AleksaHeler/Guitar-Amp/pics/original/marshall-mg10-pcb-2.jpg

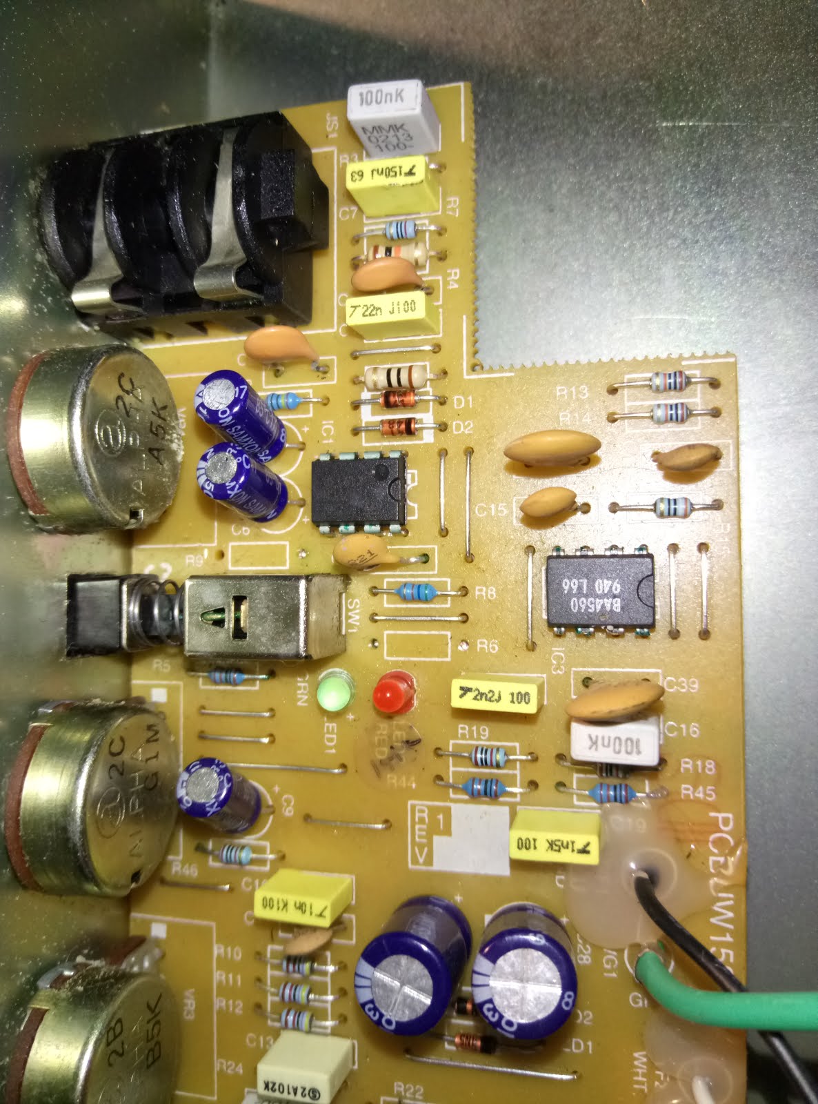
pics/original/marshall-mg10-pcb-2.jpg
