AleksaHeler/Guitar-Amp/pics/original/marshall-mg10-pcb-3.jpg

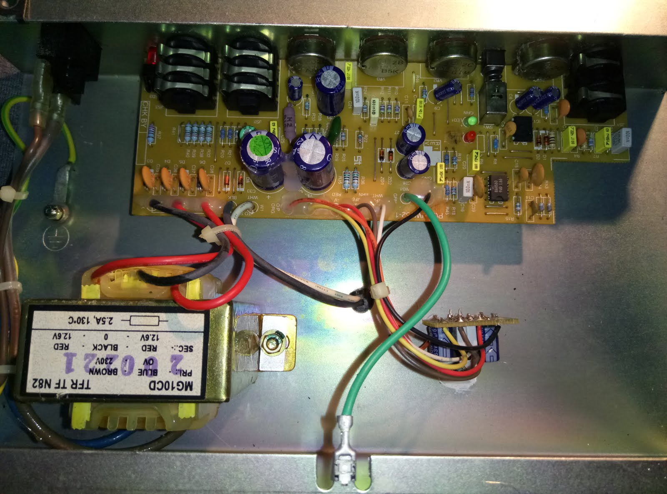
pics/original/marshall-mg10-pcb-3.jpg
