AleksaHeler/Guitar-Amp/README.md

# Guitar-Amp

Making a solid state combo guitar amp from scratch, based on Marshall MG10 with some custom modifications.

I'm designing my own schematic and PCB, and making the wooden speaker cabinet.

## Resources

...

## Schematic

...

## PCB

...
