AleksaHeler/Guitar-Amp/docs/pcb.png

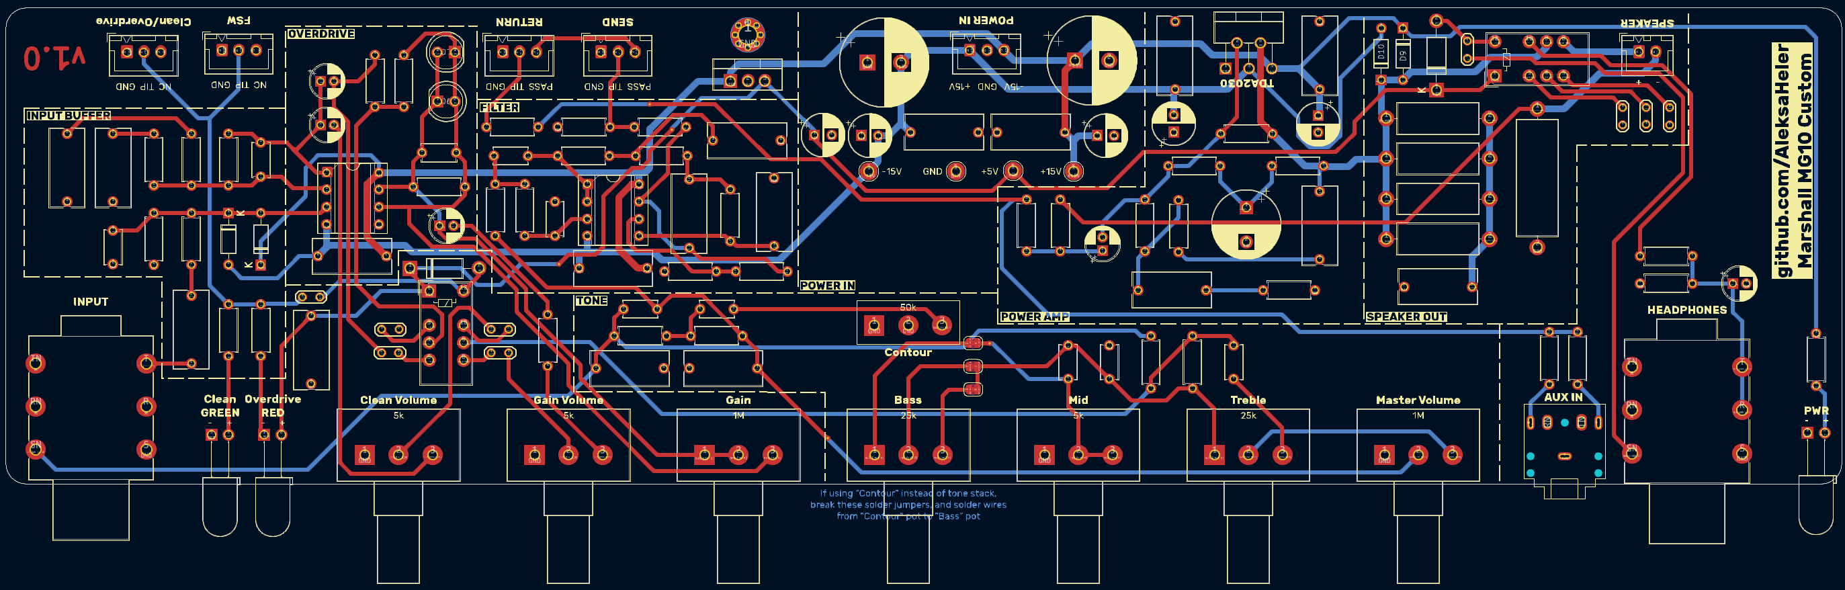
docs/pcb.png
