AleksaHeler/Guitar-Amp/docs/pcb_3d_view.png

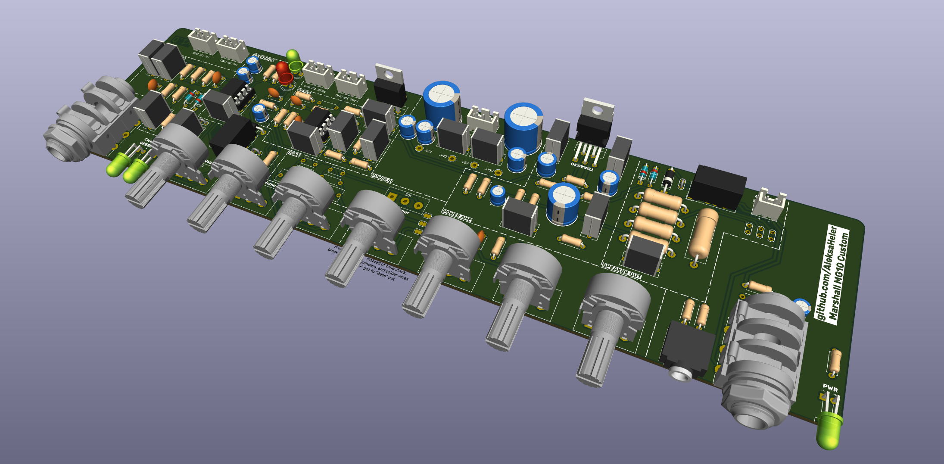
docs/pcb_3d_view.png
