AleksaHeler/Guitar-Amp/docs/pcb_top_view.png

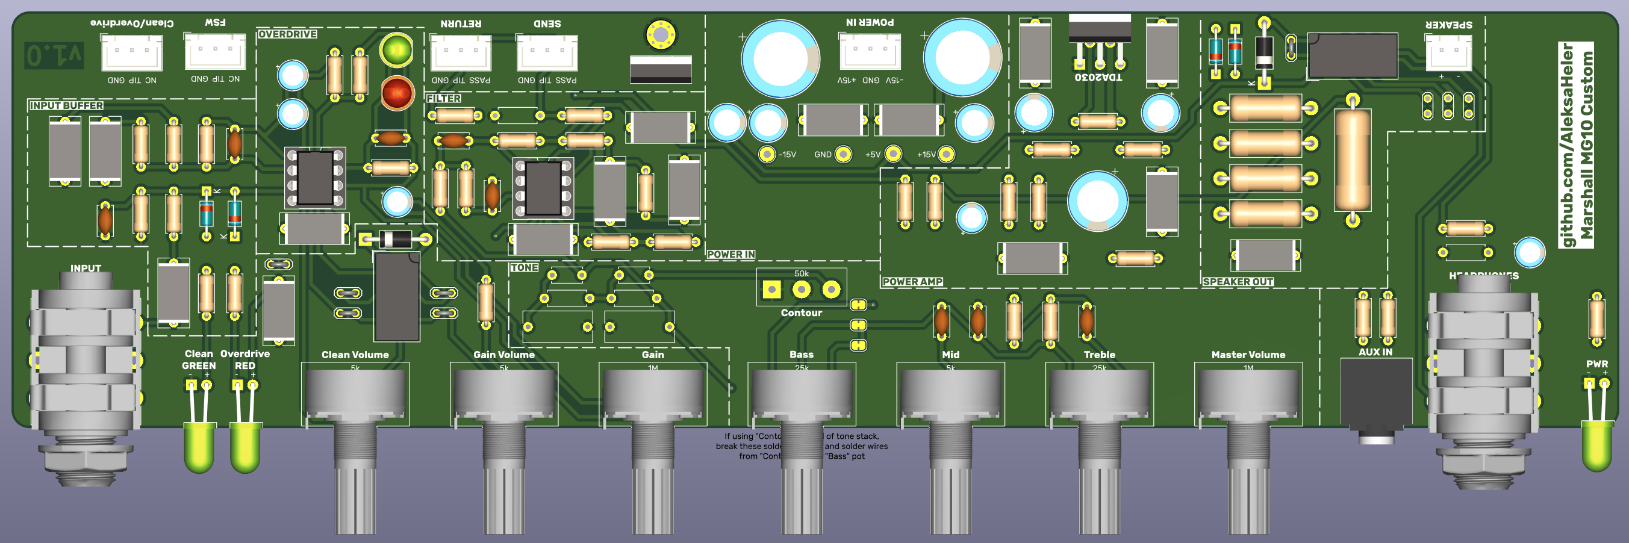
docs/pcb_top_view.png
