AleksaHeler/Guitar-Amp/pics/original/marshall_amp.webp

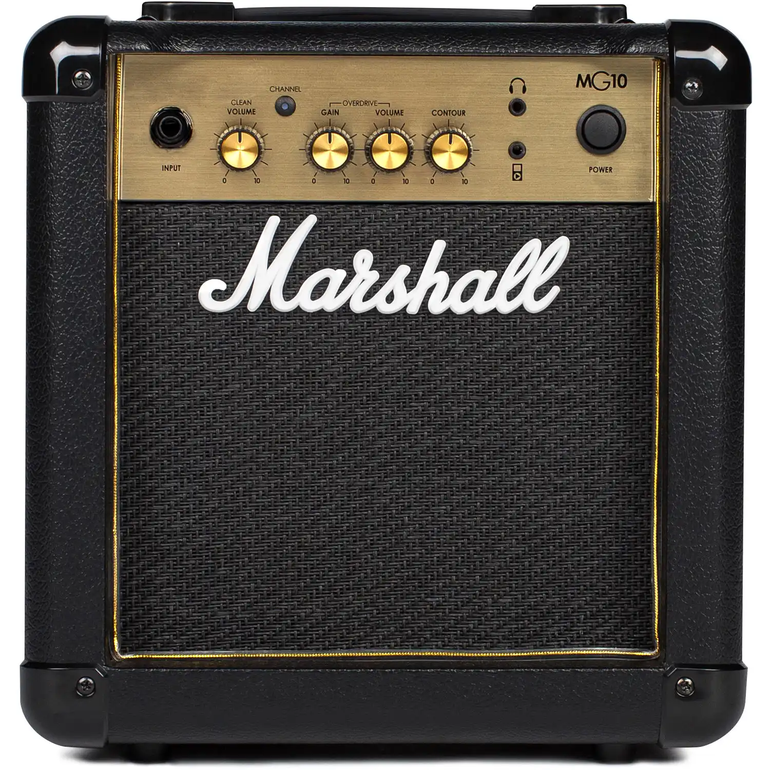
pics/original/marshall_amp.webp
