AleksaHeler/Guitar-Amp/my_mg10/models/6.35mm Mono Jack Socket Connector.STEP

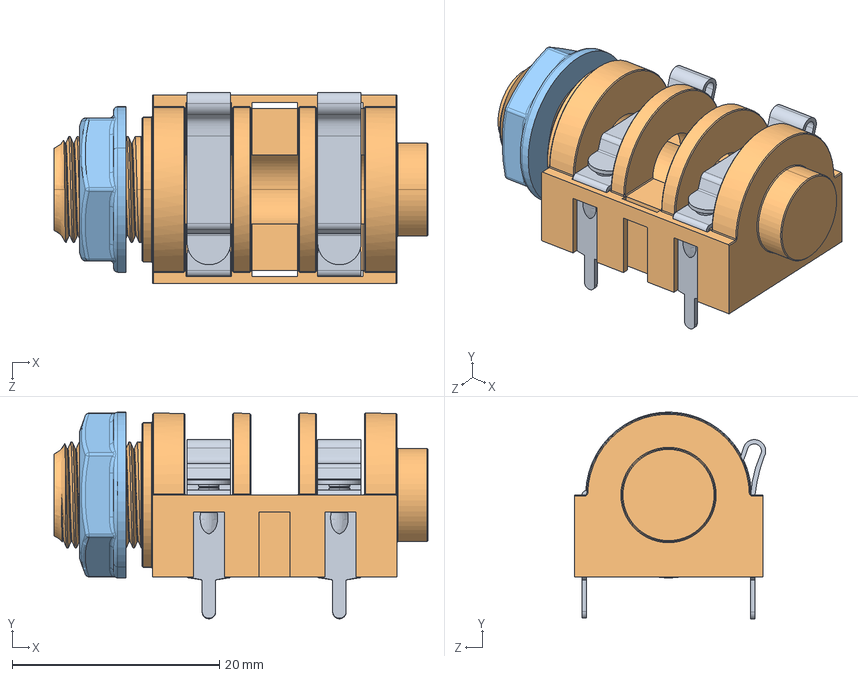
[picture p7: CAD file, 2025-08-31]
my_mg10/models/6.35mm Mono Jack Socket Connector.STEP
36.1 x 19.9 x 18.5 mm
6_3 Jack body
Nut
6_3 Jack contact_01 x 2
6_3 Jack contact_02 x 2
