AleksaHeler/Guitar-Amp/my_mg10/models/potentiometer_B10K.STEP

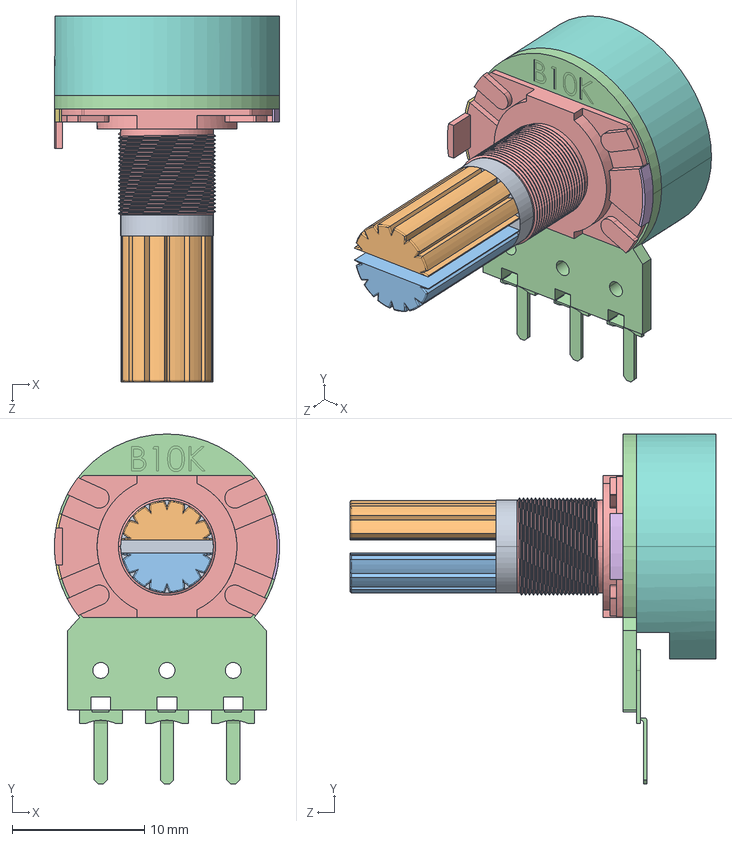
[picture p8: CAD file, 2025-08-31]
my_mg10/models/potentiometer_B10K.STEP
17.0 x 26.4 x 27.6 mm
