AleksaHeler/Guitar-Amp/docs/schematic_v1.0.pdf

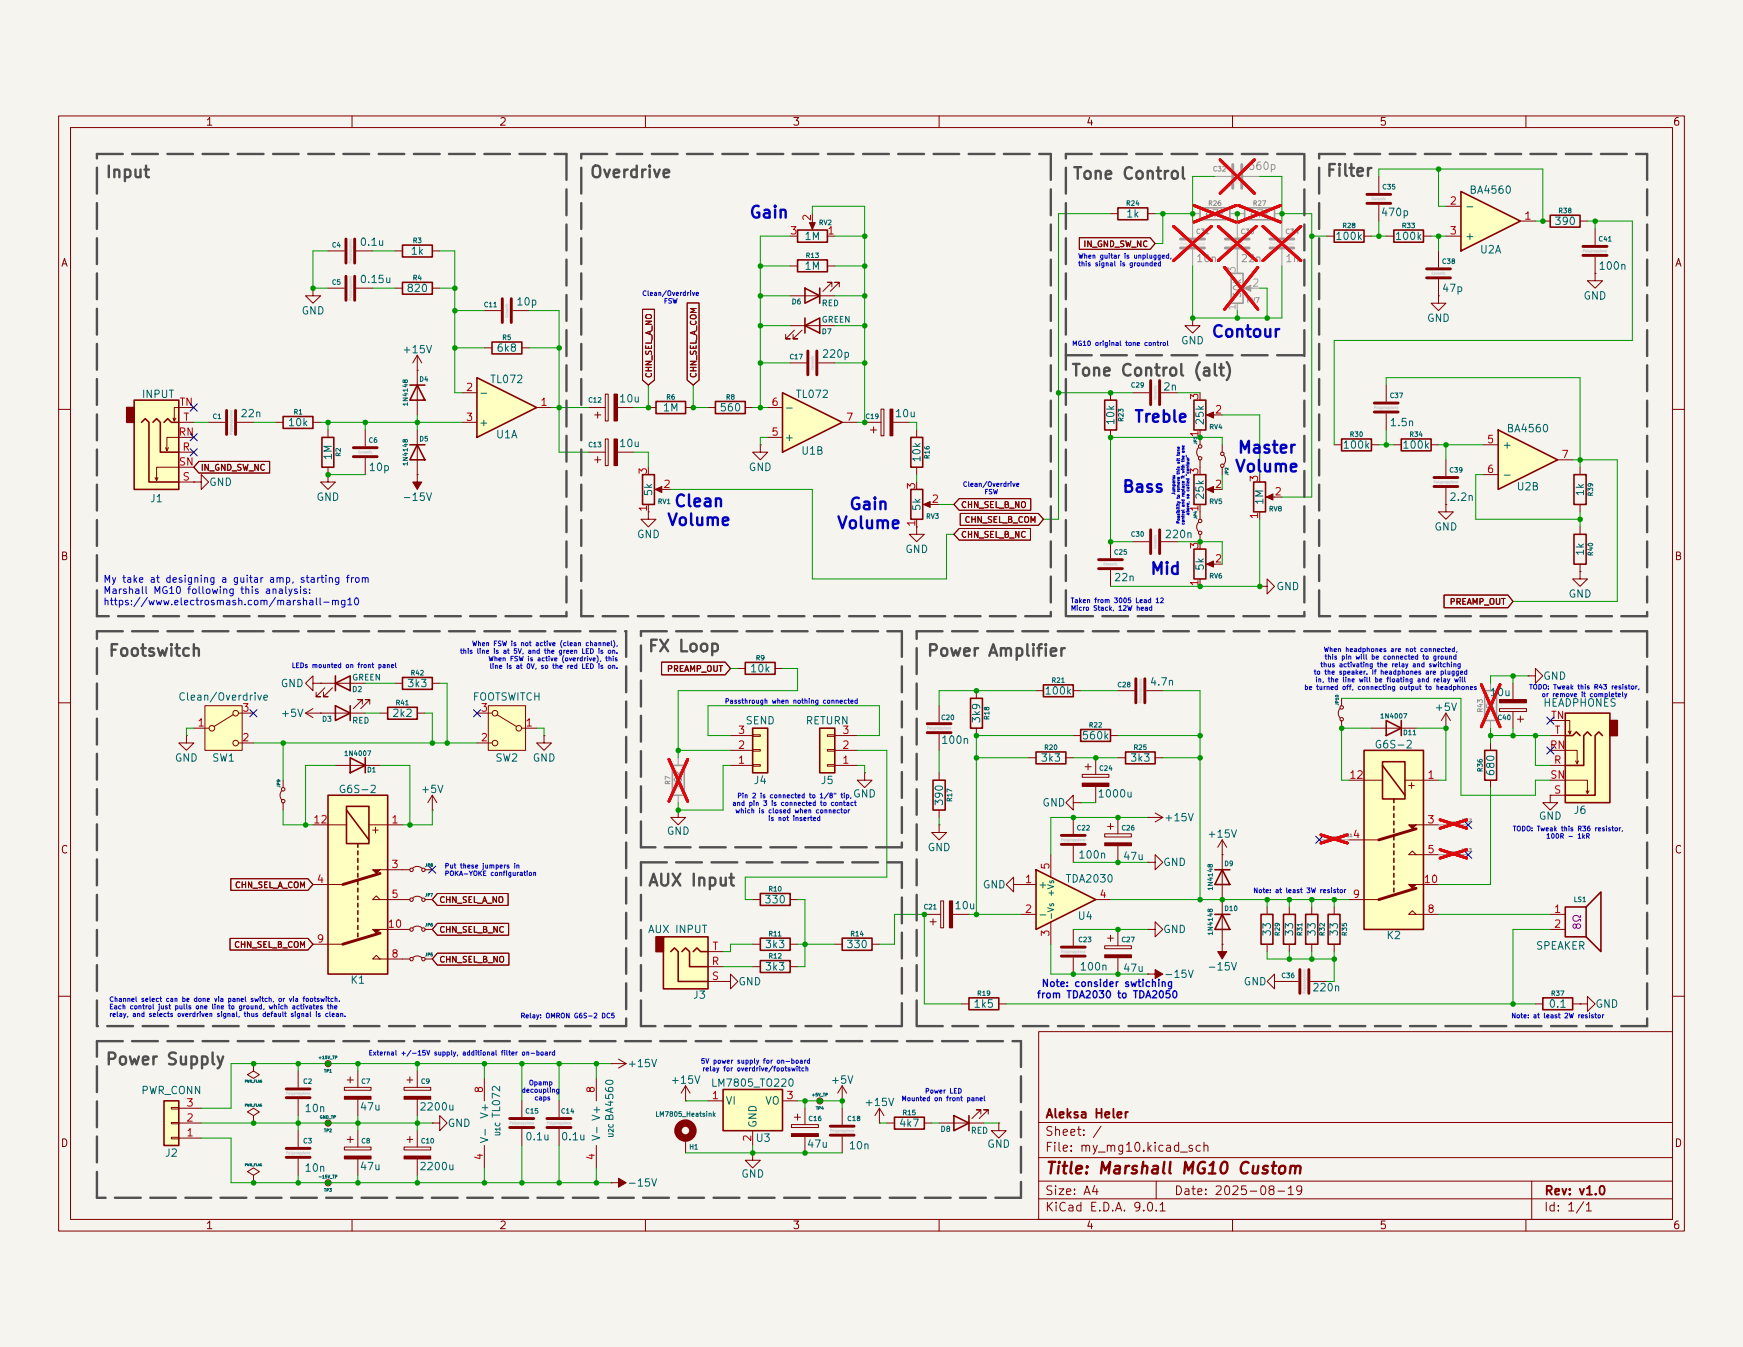
[picture p9: page 1]
