AleksaHeler/Guitar-Amp/my_mg10/my_mg10.kicad_pcb

## KiCad design my_mg10/my_mg10.kicad_pcb (2025-09-01)

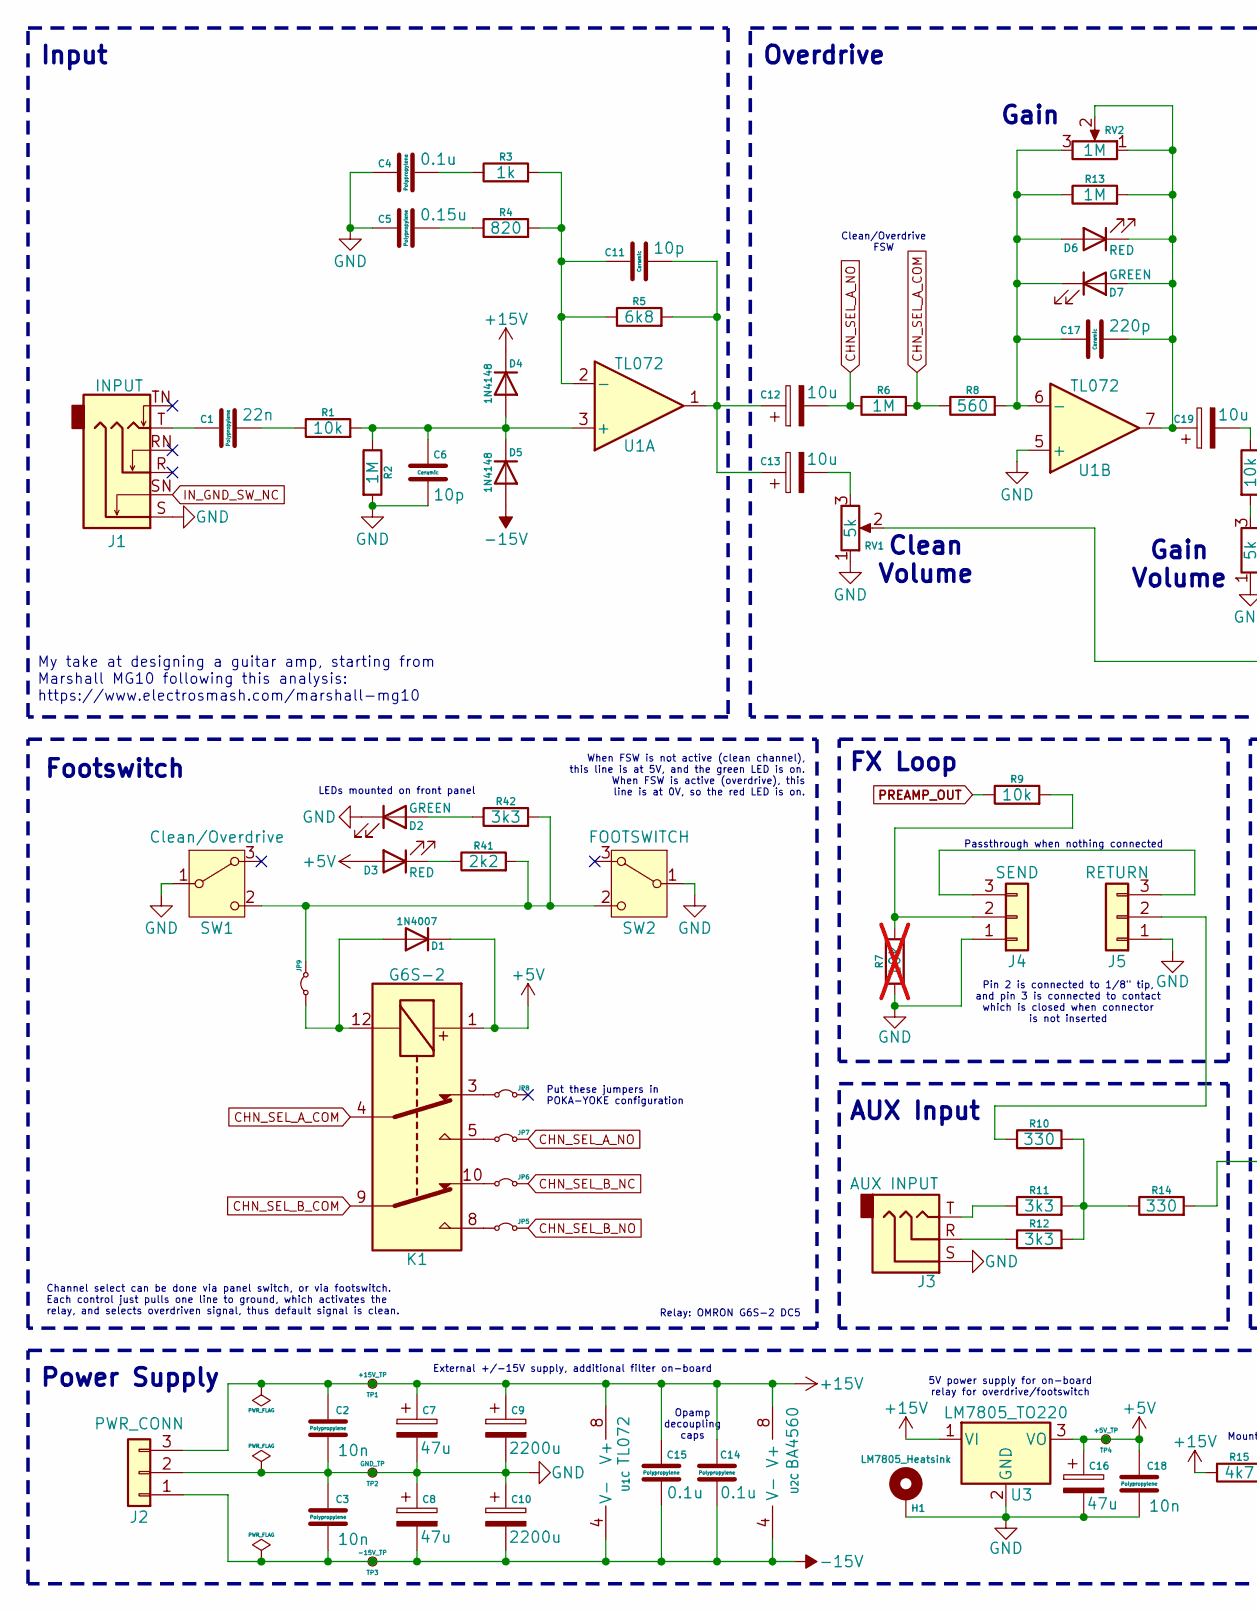
[picture p10: schematic my_mg10.kicad_sch, Marshall MG10 Custom, part in row 1, column 1]

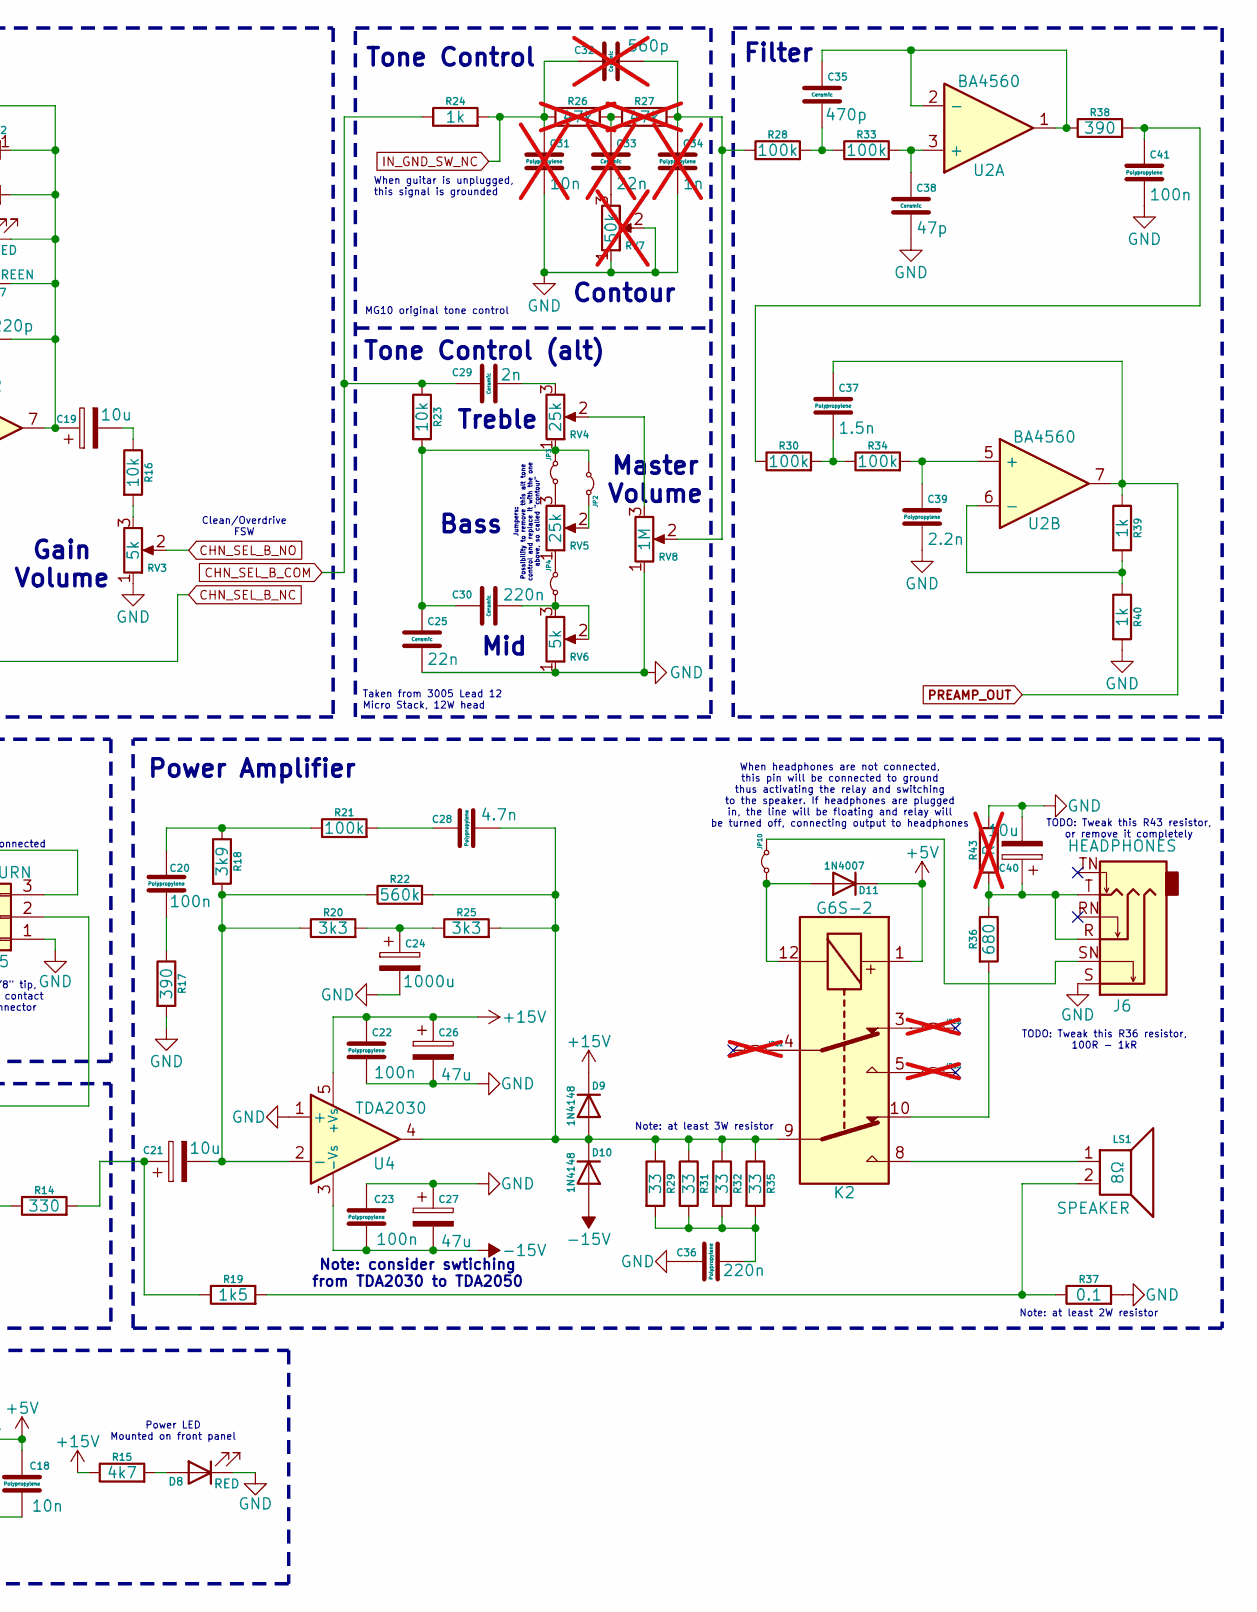
[picture p11: schematic my_mg10.kicad_sch, Marshall MG10 Custom, part in row 1, column 2]

Parts:
C1: 22n; C_Rect_L11.5mm_W5.1mm_P10.00mm_MKT
C2, C3, C18: 10n; C_Rect_L11.5mm_W5.1mm_P10.00mm_MKT
C4, C14, C15: 0.1u; C_Rect_L11.5mm_W5.1mm_P10.00mm_MKT
C5: 0.15u; C_Rect_L11.5mm_W5.1mm_P10.00mm_MKT
C6, C11: 10p; C_Disc_D5.0mm_W2.5mm_P5.00mm
C7, C8, C16, C26, C27: 47u; CP_Radial_D6.3mm_P2.50mm
C9, C10: 2200u; CP_Radial_D13.0mm_P5.00mm
C12, C13, C19, C21, C40: 10u; CP_Radial_D5.0mm_P2.00mm
C17: 220p; C_Disc_D5.0mm_W2.5mm_P5.00mm
C20, C22, C23, C41: 100n; C_Rect_L11.5mm_W5.1mm_P10.00mm_MKT
C24: 1000u; CP_Radial_D10.0mm_P5.00mm
C25: 22n; C_Disc_D5.0mm_W2.5mm_P5.00mm
C28: 4.7n; C_Rect_L11.5mm_W5.1mm_P10.00mm_MKT
C29: 2n; C_Disc_D5.0mm_W2.5mm_P5.00mm
C30: 220n; C_Disc_D5.0mm_W2.5mm_P5.00mm
C31: 10n; C_Rect_L11.5mm_W5.1mm_P10.00mm_MKT; not fitted
C32: 560p; C_Disc_D5.0mm_W2.5mm_P5.00mm; not fitted
C33: 22n; C_Disc_D5.0mm_W2.5mm_P5.00mm; not fitted
C34: 1n; C_Rect_L11.5mm_W5.1mm_P10.00mm_MKT; not fitted
C35: 470p; C_Disc_D5.0mm_W2.5mm_P5.00mm
C36: 220n; C_Rect_L11.5mm_W5.1mm_P10.00mm_MKT
C37: 1.5n; C_Rect_L11.5mm_W5.1mm_P10.00mm_MKT
C38: 47p; C_Disc_D5.0mm_W2.5mm_P5.00mm
C39: 2.2n; C_Rect_L11.5mm_W5.1mm_P10.00mm_MKT
D1, D11: 1N4007; D_DO-41_SOD81_P10.16mm_Horizontal
D2: GREEN; LED_D5.0mm_Horizontal_O6.35mm_Z3.0mm
D3, D8: RED; LED_D5.0mm_Horizontal_O6.35mm_Z3.0mm
D4, D5, D9, D10: 1N4148; D_DO-35_SOD27_P7.62mm_Horizontal
D6: RED; LED_D5.0mm
D7: GREEN; LED_D5.0mm
H1: LM7805_Heatsink; MountingHole_2.5mm_Pad_Via
J1: INPUT; Jack_6.35mm_Neutrik_NMJ6HFD2_Horizontal
J2: PWR_CONN; JST_XH_B3B-XH-A_1x03_P2.50mm_Vertical
J3: AUX INPUT; Jack_3.5mm_CUI_SJ1-3525N_Horizontal
J4: SEND; JST_XH_B3B-XH-A_1x03_P2.50mm_Vertical
J5: RETURN; JST_XH_B3B-XH-A_1x03_P2.50mm_Vertical
J6: HEADPHONES; Jack_6.35mm_Neutrik_NMJ6HFD2_Horizontal
JP2, JP3, JP4: SolderJumper-2_P1.3mm_Bridged_RoundedPad1.0x1.5mm
JP5, JP6, JP7, JP8, JP9, JP10: TestPoint_2Pads_Pitch2.54mm_Drill0.8mm
JP11, JP12, JP13: TestPoint_2Pads_Pitch2.54mm_Drill0.8mm; not fitted
K1, K2: G6S-2; Relay_DPDT_Omron_G6S-2
LS1: SPEAKER; JST_XH_B2B-XH-A_1x02_P2.50mm_Vertical
R1, R9, R16, R23: 10k; R_Axial_DIN0207_L6.3mm_D2.5mm_P7.62mm_Horizontal
R2, R6, R13: 1M; R_Axial_DIN0207_L6.3mm_D2.5mm_P7.62mm_Horizontal
R3, R24, R39, R40: 1k; R_Axial_DIN0207_L6.3mm_D2.5mm_P7.62mm_Horizontal
R4: 820; R_Axial_DIN0207_L6.3mm_D2.5mm_P7.62mm_Horizontal
R5: 6k8; R_Axial_DIN0207_L6.3mm_D2.5mm_P7.62mm_Horizontal
R7: 10k; R_Axial_DIN0207_L6.3mm_D2.5mm_P7.62mm_Horizontal; not fitted
R8: 560; R_Axial_DIN0207_L6.3mm_D2.5mm_P7.62mm_Horizontal
R10, R14: 330; R_Axial_DIN0207_L6.3mm_D2.5mm_P7.62mm_Horizontal
R11, R12, R20, R25, R42: 3k3; R_Axial_DIN0207_L6.3mm_D2.5mm_P7.62mm_Horizontal
R15: 4k7; R_Axial_DIN0207_L6.3mm_D2.5mm_P7.62mm_Horizontal
R17, R38: 390; R_Axial_DIN0207_L6.3mm_D2.5mm_P7.62mm_Horizontal
R18: 3k9; R_Axial_DIN0207_L6.3mm_D2.5mm_P7.62mm_Horizontal
R19: 1k5; R_Axial_DIN0207_L6.3mm_D2.5mm_P7.62mm_Horizontal
R21, R28, R30, R33, R34: 100k; R_Axial_DIN0207_L6.3mm_D2.5mm_P7.62mm_Horizontal
R22: 560k; R_Axial_DIN0207_L6.3mm_D2.5mm_P7.62mm_Horizontal
R26, R27: 47k; R_Axial_DIN0207_L6.3mm_D2.5mm_P7.62mm_Horizontal; not fitted
R29, R31, R32, R35: 33; R_Axial_DIN0414_L11.9mm_D4.5mm_P15.24mm_Horizontal
R36: 680; R_Axial_DIN0207_L6.3mm_D2.5mm_P7.62mm_Horizontal
R37: 0.1; R_Axial_DIN0617_L17.0mm_D6.0mm_P20.32mm_Horizontal
R41: 2k2; R_Axial_DIN0207_L6.3mm_D2.5mm_P7.62mm_Horizontal
R43: R; R_Axial_DIN0207_L6.3mm_D2.5mm_P7.62mm_Horizontal; not fitted
RV1, RV3, RV6: 5k; Potentiometer_Alps_RK163_Single_Horizontal
RV2, RV8: 1M; Potentiometer_Alps_RK163_Single_Horizontal
RV4, RV5: 25k; Potentiometer_Alps_RK163_Single_Horizontal
RV7: 50k; Potentiometer_Alps_RK163_Single_Horizontal; not fitted
SW1: Clean/Overdrive; JST_XH_B3B-XH-A_1x03_P2.50mm_Vertical
SW2: FOOTSWITCH; JST_XH_B3B-XH-A_1x03_P2.50mm_Vertical
TP1: +15V_TP; TestPoint_THTPad_D2.5mm_Drill1.2mm
TP2: GND_TP; TestPoint_THTPad_D2.5mm_Drill1.2mm
TP3: -15V_TP; TestPoint_THTPad_D2.5mm_Drill1.2mm
TP4: +5V_TP; TestPoint_THTPad_D2.5mm_Drill1.2mm
U1: TL072; DIP-8_W7.62mm_Socket
U2: BA4560; DIP-8_W7.62mm_Socket
U3: LM7805_TO220; TO-220-3_Vertical
U4: TDA2030; TO-220-5_P3.4x3.7mm_StaggerOdd_Lead3.8mm_Vertical

Connections:
+5V: C16.1, C18.1, D1.1 (K), D3.2 (A), D11.1 (K), K1.1, K2.1, TP4.1, U3.3 (VO)
+15V: C2.1, C7.1, C9.1, C14.1, C15.1, C22.1, C26.1, D4.1 (K), D9.1 (K), J2.3, R15.1, TP1.1, U1.8 (V+), U2.8 (V+), U3.1 (VI), U4.5 (+Vs)
-15V: C3.2, C8.2, C10.2, C14.2, C15.2, C23.2, C27.2, D5.2 (A), D10.2 (A), J2.1, TP3.1, U1.4 (V-), U2.4 (V-), U4.3 (-Vs)
CHN_SEL_A_COM: K1.4, R6.2, R8.1
CHN_SEL_A_NO: C12.2, JP7.2 (B), R6.1
CHN_SEL_B_COM: C29.1, K1.9, R23.1, R24.1
CHN_SEL_B_NC: JP6.2 (B), RV1.2
CHN_SEL_B_NO: JP5.2 (B), RV3.2
GND: C2.2, C3.1, C4.1, C5.1, C6.2, C7.2, C8.1, C9.2, C10.1, C16.2, C18.2, C22.2, C23.1, C24.2, C25.2, C26.2, C27.1, C31.2, C34.2, C36.1, C38.2, C39.2, C40.2, C41.2, D2.1 (K), D8.1 (K), H1.1, J1.S, J2.2, J3.S, J4.1, J5.1, J6.S, R2.2, R7.1, R17.2, R37.2, R40.2, R43.2, RV1.1, RV3.1, RV6.1, RV7.1, RV7.2, RV8.1, SW1.1 (B), SW2.1 (B), TP2.1, U1.5 (+), U3.2 (GND), U4.1 (+)
IN_GND_SW_NC: C31.1, C32.1, J1.SN, R24.2, R26.1
unnamed: C1.1, J1.T
unnamed: C1.2, R1.1
unnamed: C4.2, R3.1
unnamed: C5.2, R4.1
unnamed: C11.2, C12.1, C13.1, R5.2, U1.1
unnamed: C13.2, RV1.3
unnamed: C19.2, R16.1
unnamed: C20.1, R18.1, R21.1
unnamed: C20.2, R17.1
unnamed: C21.1, R14.2, R19.1
unnamed: C24.1, R20.2, R25.1
unnamed: C28.1, R21.2
unnamed: C29.2, RV4.3
unnamed: C32.2, C34.1, R27.2, R28.1, RV8.2
unnamed: C33.1, R26.2, R27.1
unnamed: C33.2, RV7.3
unnamed: C35.2, R28.2, R33.1
unnamed: C36.2, R29.2, R31.2, R32.2, R35.2
unnamed: C37.2, R30.2, R34.1
unnamed: C40.1, J6.R, J6.T, R36.1, R43.1
unnamed: C41.1, R30.1, R38.2
unnamed: D1.2 (A), JP9.1 (A), K1.12
unnamed: D2.2 (A), R42.1
unnamed: D3.1 (K), R41.1
unnamed: C6.1, D4.2 (A), D5.1 (K), R1.2, R2.1, U1.3 (+)
unnamed: C17.1, D6.2 (A), D7.1 (K), R8.2, R13.1, RV2.3, U1.6 (-)
unnamed: C17.2, C19.1, D6.1 (K), D7.2 (A), R13.2, RV2.1, RV2.2, U1.7
unnamed: D8.2 (A), R15.2
unnamed: C28.2, D9.2 (A), D10.1 (K), K2.9, R22.2, R25.2, R29.1, R31.1, R32.1, R35.1, U4.4
unnamed: D11.2 (A), JP10.1 (A), K2.12
unnamed: J3.R, R12.1
unnamed: J3.T, R11.1
unnamed: J4.2, R7.2, R9.2
unnamed: J4.3, J5.3
unnamed: J5.2, R10.1
unnamed: C25.1, C30.1, JP2.1 (A), JP3.2 (B), R23.2, RV4.1
unnamed: JP2.2 (B), RV5.2
unnamed: JP3.1 (A), RV5.3
unnamed: C30.2, JP4.1 (A), RV6.2, RV6.3
unnamed: JP4.2 (B), RV5.1
unnamed: JP5.1 (A), K1.8
unnamed: JP6.1 (A), K1.10
unnamed: JP7.1 (A), K1.5
unnamed: JP8.1 (A), K1.3
unnamed: JP9.2 (B), R41.2, R42.2, SW1.2 (C), SW2.2 (C)
unnamed: J6.SN, JP10.2 (B)
unnamed: JP11.2 (B), K2.4
unnamed: JP12.1 (A), K2.3
unnamed: JP13.1 (A), K2.5
unnamed: K2.8, LS1.1
unnamed: K2.10, R36.2
unnamed: LS1.2, R19.2, R37.1
unnamed: R10.2, R11.2, R12.2, R14.1
unnamed: R16.2, RV3.3
unnamed: RV4.2, RV8.3
unnamed: C11.1, R3.2, R4.2, R5.1, U1.2 (-)
unnamed: C38.1, R33.2, U2.3 (+)
unnamed: C35.1, R38.1, U2.1, U2.2 (-)
unnamed: C39.1, R34.2, U2.5 (+)
unnamed: R39.2, R40.1, U2.6 (-)
unnamed: C21.2, R18.2, R20.1, R22.1, U4.2 (-)
PREAMP_OUT: C37.1, R9.1, R39.1, U2.7

Notes on the sheet:
Gain
External +/-15V supply, additional filter on-board
Treble
MG10 original tone control
When FSW is not active (clean channel), this line is at 5V, and the green LED is on. When FSW is active (overdrive), this line is at 0V, so the red LED is on.
5V power supply for on-board relay for overdrive/footswitch
Mid
Channel select can be done via panel switch, or via footswitch. Each control just pulls one line to ground, which activates the relay, and selects overdriven signal, thus default signal is clean.
AUX Input
Tone Control (alt)
Power Amplifier
Jumpers: Possibility to remove this alt tone control and replace it with the one above, so called "contour"
Relay: OMRON G6S-2 DC5
TODO: Tweak this R36 resistor, 100R - 1kR
Filter
Taken from 3005 Lead 12 Micro Stack, 12W head
Power Supply
Gain Volume
Opamp decoupling caps
FX Loop
Clean/Overdrive FSW
Passthrough when nothing connected
Master Volume
Footswitch
Bass
Put these jumpers in POKA-YOKE configuration
Input
Note: consider swtiching from TDA2030 to TDA2050
Power LED Mounted on front panel
Overdrive
Clean Volume
Pin 2 is connected to 1/8" tip, and pin 3 is connected to contact which is closed when connector is not inserted
When headphones are not connected, this pin will be connected to ground thus activating the relay and switching to the speaker. If headphones are plugged in, the line will be floating and relay will be turned off, connecting output to headphones
Contour
TODO: Tweak this R43 resistor, or remove it completely
LEDs mounted on front panel
When guitar is unplugged, this signal is grounded
Tone Control
Note: at least 3W resistor
Note: at least 2W resistor
My take at designing a guitar amp, starting from Marshall MG10 following this analysis: https://www.electrosmash.com/marshall-mg10

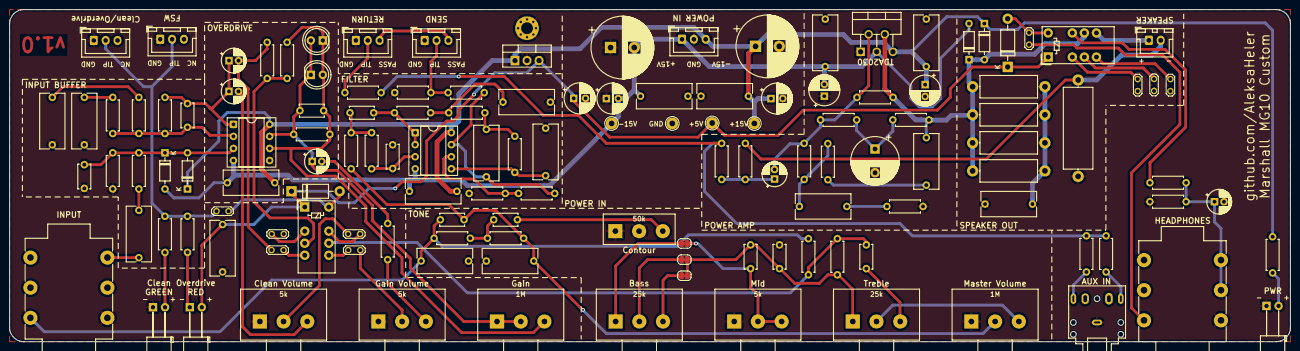
[picture p12: board my_mg10.kicad_pcb from above]

Board: 2 copper layers, 270.0 x 70.0 mm, 135 parts (0 on the bottom side), 72 nets.
