AleksaHeler/Guitar-Amp/(commit log)

2025-09-01 Minor file tweaks
    [my_mg10-B_Cu.gbr, my_mg10-B_Mask.gbr, my_mg10-B_Paste.gbr, my_mg10-B_Silkscreen.gbr, my_mg10-Edge_Cuts.gbr, my_mg10-F_Cu.gbr, my_mg10-F_Mask.gbr, my_mg10-F_Paste.gbr]
2025-09-01 Added headphone out switching, added pictures
    [my_mg10-B_Cu.gbr, my_mg10-B_Mask.gbr, my_mg10-B_Paste.gbr, my_mg10-B_Silkscreen.gbr, my_mg10-Edge_Cuts.gbr, my_mg10-F_Cu.gbr, my_mg10-F_Mask.gbr, my_mg10-F_Paste.gbr]
